ejuoy/Jump_starter/Doc/MCU-BT(1).pdf

# R8 22R ⁰⁶⁰³ C¹ ¹⁰uF/16V

## BT part

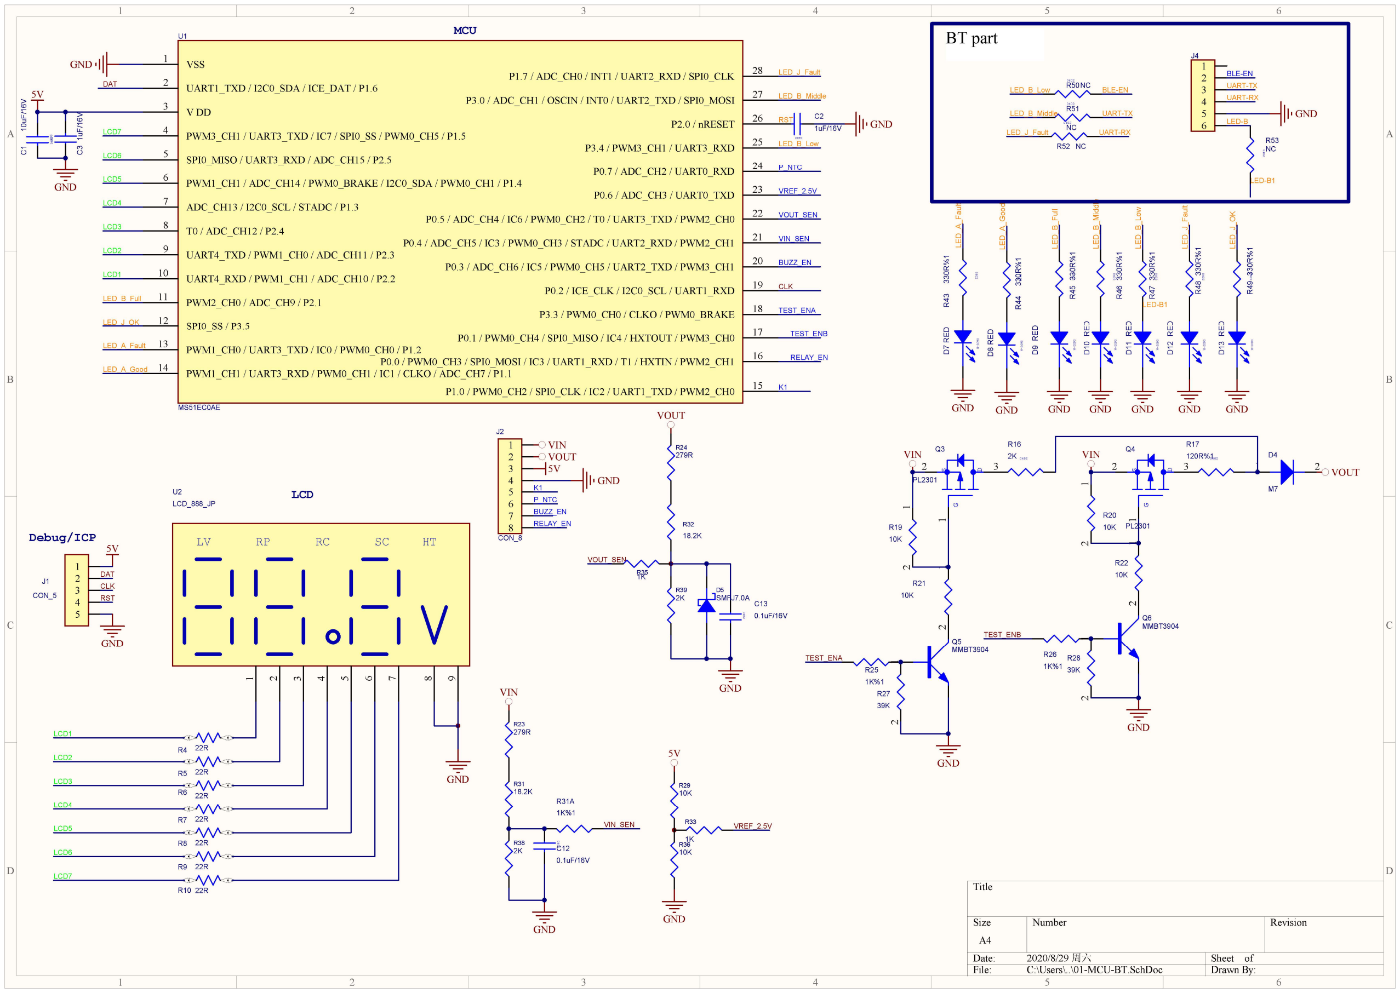
[picture p4: page 1]

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
Title

Size | Number | Revision
A4
Date: | 2020/8/29 周六 | Sheet of
File: | C:\Users\..\01-MCU-BT.SchDoc | Drawn By:

DAT
CLK
RST

LCD1

LCD2

LCD3

LCD4

LCD5

LCD6

LCD7

P_NTC

VREF_2.5V

VOUT_SEN

VIN_SEN

BUZZ_EN

TEST_ENA

TEST_ENB

CLK

DAT

RELAY_EN

LED_A_Fault

LED_A_Good

LCD1

LCD2

LCD3

LCD4

LCD5

LCD6

LCD7

LED_B_Full

LED_B_Middle

LED_B_Low

LED_J_Fault

LED_J_OK

LV | RP | RC | SC | HT 1

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
LCD_888_JP

R4 22R

VSS 1

UART1_TXD / I2C0_SDA / ICE_DAT / P1.6 2

V DD 3

PWM3_CH1 / UART3_TXD / IC7 / SPI0_SS / PWM0_CH5 / P1.5 4

SPI0_MISO / UART3_RXD / ADC_CH15 / P2.5 5

PWM1_CH1 / ADC_CH14 / PWM0_BRAKE / I2C0_SDA / PWM0_CH1 / P1.4 6

ADC_CH13 / I2C0_SCL / STADC / P1.3 7

T0 / ADC_CH12 / P2.4 8

UART4_TXD / PWM1_CH0 / ADC_CH11 / P2.3 9

UART4_RXD / PWM1_CH1 / ADC_CH10 / P2.2 10

PWM2_CH0 / ADC_CH9 / P2.1 11

SPI0_SS / P3.5 12

PWM1_CH0 / UART3_TXD / IC0 / PWM0_CH0 / P1.2 13

PWM1_CH1 / UART3_RXD / PWM0_CH1 / IC1 / CLKO / ADC_CH7 / P1.1 14
P1.0 / PWM0_CH2 / SPI0_CLK / IC2 / UART1_TXD / PWM2_CH0 | 15
P0.0 / PWM0_CH3 / SPI0_MOSI / IC3 / UART1_RXD / T1 / HXTIN / PWM2_CH1 | 16
P0.1 / PWM0_CH4 / SPI0_MISO / IC4 / HXTOUT / PWM3_CH0 | 17
P3.3 / PWM0_CH0 / CLKO / PWM0_BRAKE | 18
P0.2 / ICE_CLK / I2C0_SCL / UART1_RXD | 19
P0.3 / ADC_CH6 / IC5 / PWM0_CH5 / UART2_TXD / PWM3_CH1 | 20
P0.4 / ADC_CH5 / IC3 / PWM0_CH3 / STADC / UART2_RXD / PWM2_CH1 | 21
P0.5 / ADC_CH4 / IC6 / PWM0_CH2 / T0 / UART3_TXD / PWM2_CH0 | 22
P0.6 / ADC_CH3 / UART0_TXD | 23
P0.7 / ADC_CH2 / UART0_RXD | 24
P3.4 / PWM3_CH1 / UART3_RXD | 25
P2.0 / nRESET | 26
P3.0 / ADC_CH1 / OSCIN / INT0 / UART2_TXD / SPI0_MOSI | 27
P1.7 / ADC_CH0 / INT1 / UART2_RXD / SPI0_CLK | 28

U1

MS51EC0AE

R5 22R

R6 22R ⁰⁴⁰² | C³ ¹uF/16V | 0402

C2
1uF/16V

R7 22R

R9 22R

1
2
3
4
5

J1
CON_5

R10 22R

5V

5V

### LCD

### MCU

### Debug/ICP

VREF_2.5V

R29
10K

R33

1K
R36
10K

5V

VOUT_SEN

R39
2K

R24
279R

R32
18.2K

R35 1K

D5
SMFJ7.0A0402
C13
0.1uF/16V

VOUT

VIN_SEN

R38
2K

R31
18.2K 0402 C12

0.1uF/16V

R23
279R

VIN

R31A
1K%1

TEST_ENB

TEST_ENA | R26
1K%1 | 1 2
| R22
10K ¹ 2

R21
10K

R25
1K%1

Q6

MMBT3904 D

G

S 1

2 3

Q3

PL2301 | D

G

S 1

2 3

Q4

PL2301

0402

R17
120R%1 1 2

R28
39K

1 2

R19

10K | 1 2

R20
10K

0402

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
MMBT3904

VIN
VOUT
VIN | LED_A_Fault | LED_A_Good | LED_B_Full | LED_B_Middle | LED_B_Low | LED_J_Fault | LED_J_OK 0603-R D¹² RED ⁰⁴⁰² R⁴⁵ ³³⁰R%¹ | 0402 R⁴⁶ ³³⁰R%¹ | 0603-R D¹³ RED 0603-R D⁷ RED | 0402 R⁴⁹ ³³⁰R%¹ 0603-R D¹⁰ RED ⁰⁴⁰² R⁴⁴ ³³⁰R%¹ | 0402 R⁴⁷ ³³⁰R%¹ 0603-R D¹¹ RED | 0402 R⁴⁸ ³³⁰R%¹ 0603-R D⁹ RED ⁰⁴⁰² R⁴³ ³³⁰R%¹ | 0603-R D⁸ RED

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
CON_8

VIN
VOUT
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
GND | GND | GND | GND | GND | GND | GND

RELAY_EN

P_NTC
BUZZ_EN

0402
R50NC LED_B_Low | BLE-EN

0402
R51

NC

LED_B_Middle | UART-TX

0402

R52 NC

UART-RX

K1

LED-B1 ⁰⁴⁰²

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
BLE-EN
UART-TX
UART-RX

LED-B

GND

K1

RST

LED-B1

LED_J_Fault
