ejuoy/Jump_starter/Doc/继电器-sch(1).pdf

1

2

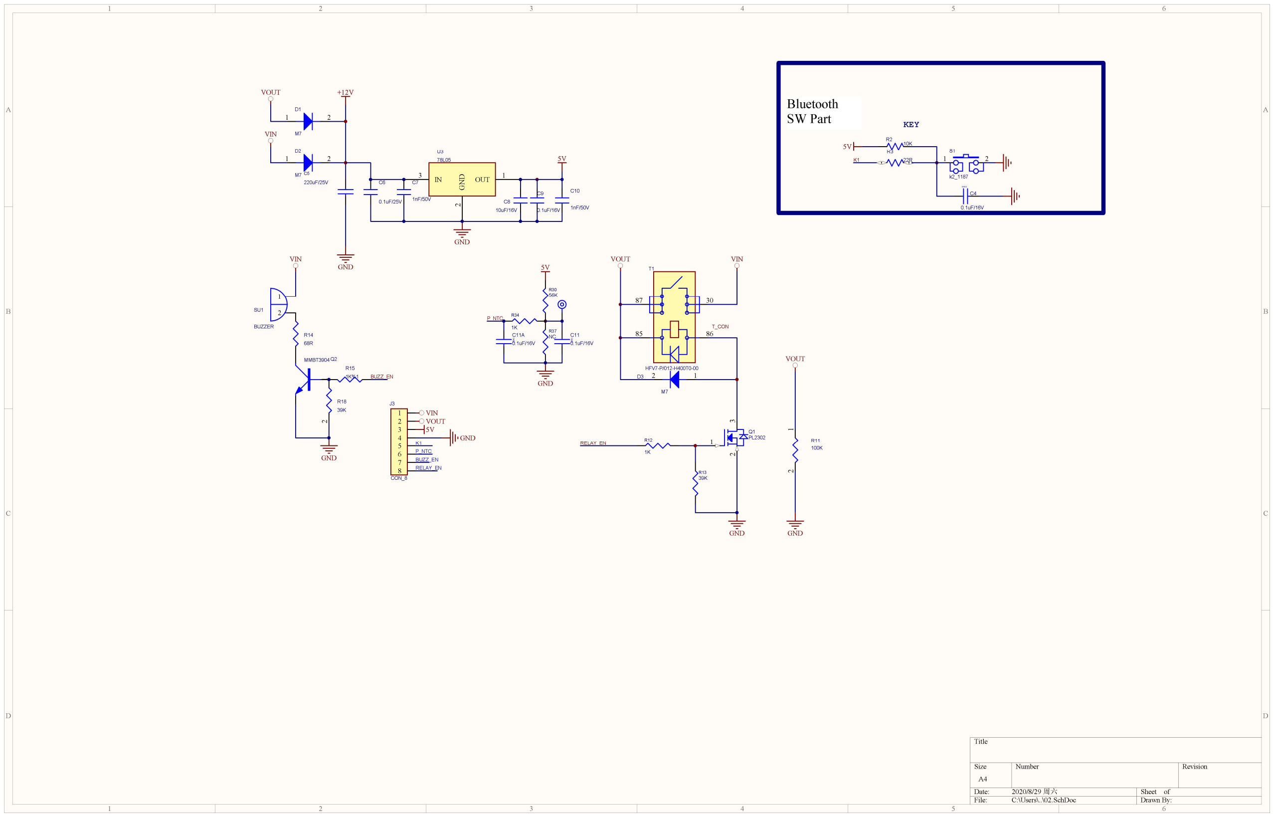
[picture p5: page 1]

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
## Title

Size | Number | Revision
A4
Date: | 2020/8/29 周六 | Sheet of
File: | C:\Users\..\02.SchDoc | Drawn By:

RELAY_EN

P_NTC
T_CON

C9

0.1uF/16V

R13
39K

C7

1nF/50V

85 86

87 30

T1

HFV7-P/012-H400T0-00

## OUT 1 GND

2

IN 3

U3
78L05

C10

1nF/50V

D3 | 2 | 1

M7

C5
220uF/25V

1 2

D2

M7
C6

0.1uF/25V

3

1 2

Q1
PL2302

1 2

D1

M7

R30
56K

C8
10uF/16V

R12

1K | 1 2
R11
100K

R34

1K
R37
NC C11 0402 0.1uF/16V

+12V

5V

## VIN

## VOUT

## VOUT

VOUT | VIN

BUZZ_EN

MMBT3904Q2

1

2

SU1

BUZZER
R14
68R

R15
1K%1 1 2

R18
39K

## VIN

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
CON_8

## VIN VOUT

5V

## GND

RELAY_EN

P_NTC
BUZZ_EN

## GND

## GND

## GND

## GND

## GND

## GND

K1

K1

R2
10K

0402
C4

0.1uF/16V

1 2

S1

k2_1187

R3
22R

5V

## KEY

# Bluetooth SW Part

C11A 0402 0.1uF/16V
