ejuoy/Jump_starter/Doc/JSBT100.pdf

# POWER- POWER-

# 14.8V POWER-

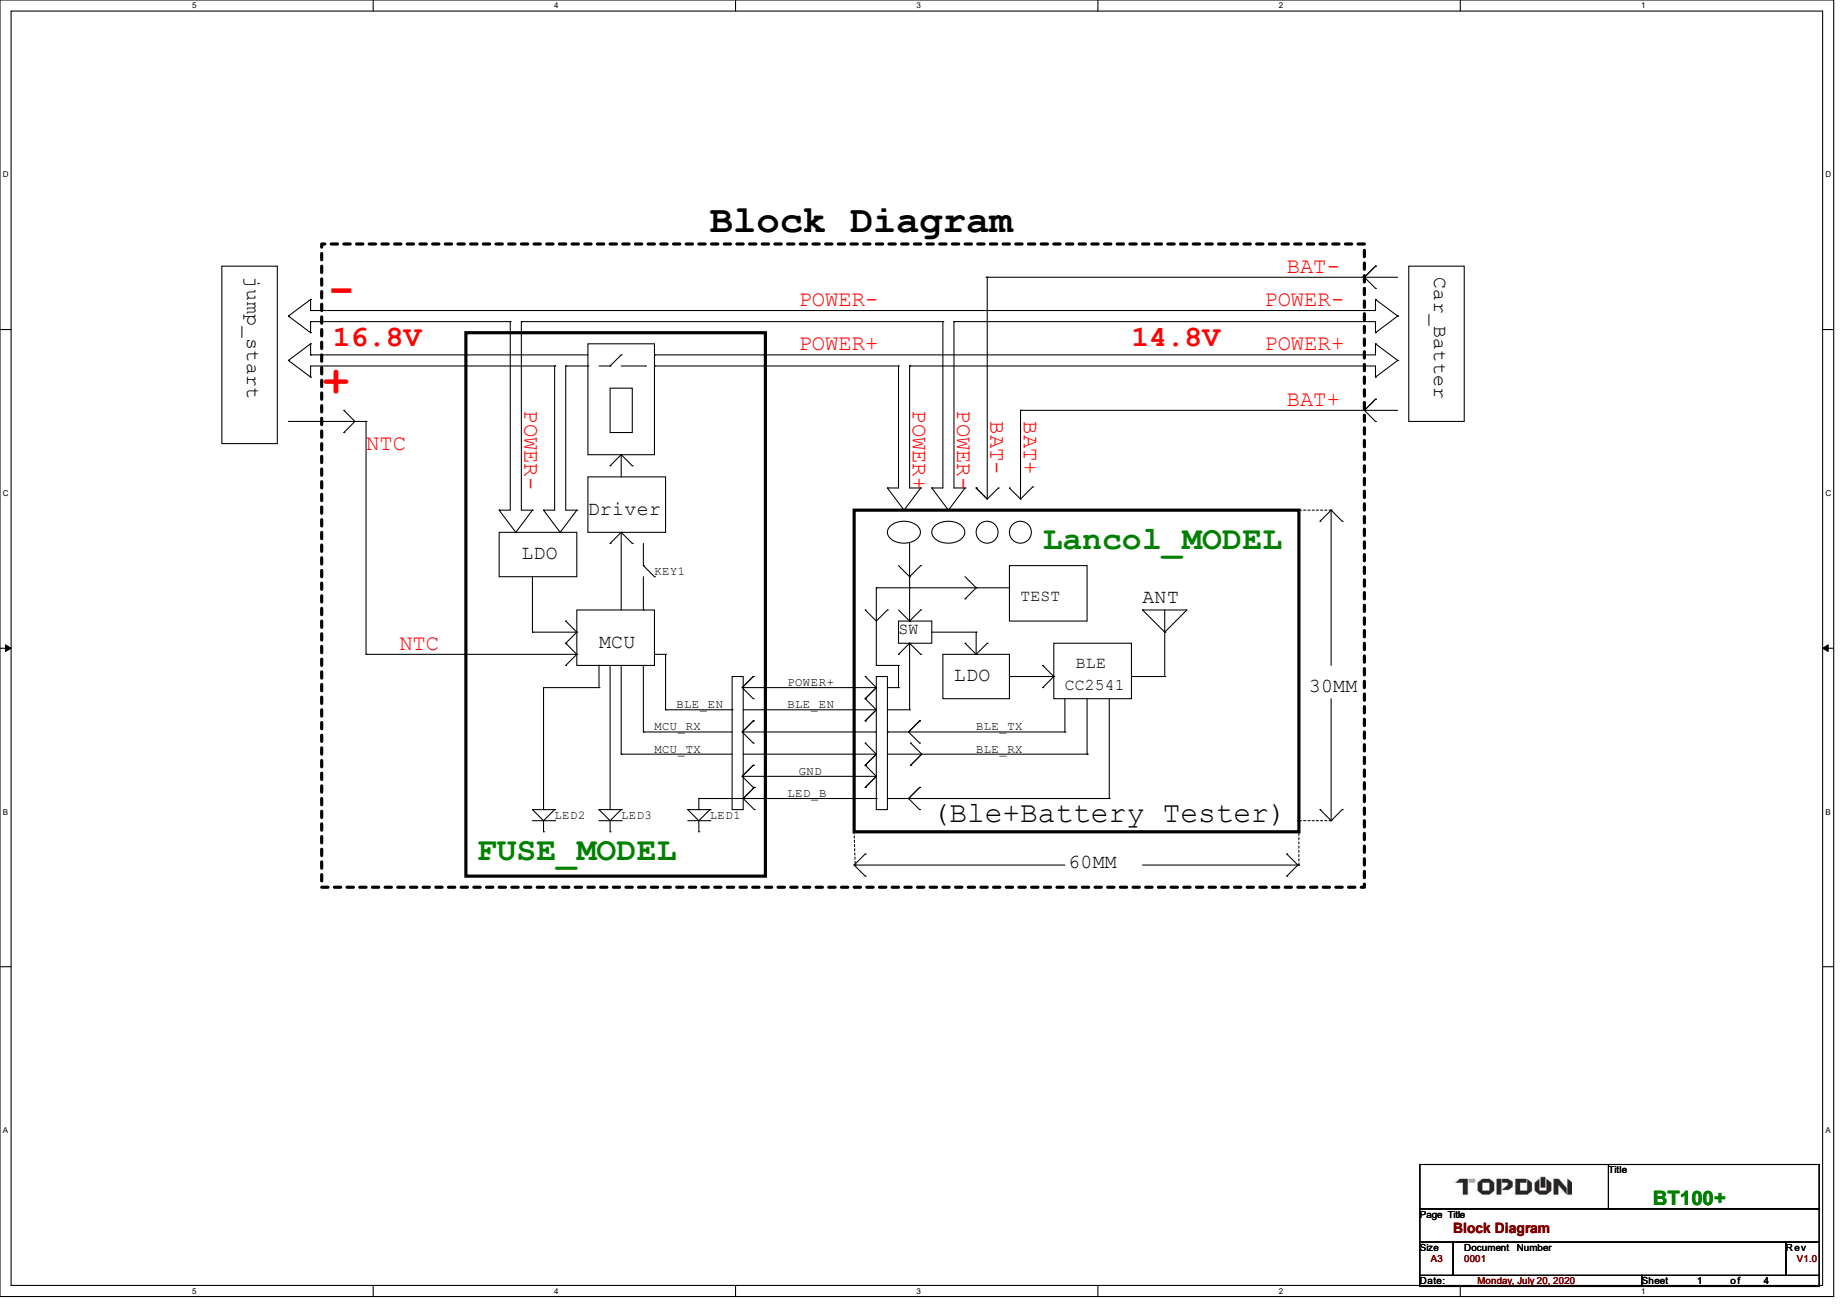
[picture p8: page 1]
Lancol_MODEL; MCU jump_start; BAT-; Car_Batter; BAT+; POWER+; (Ble+Battery Tester); 30MM BAT- BAT+; FUSE_MODEL; POWER-; LDO; Driver; LED2; LED3; LED1; KEY1; NTC; BLE; TEST; CC2541 LDO; ANT; Block Diagram; MCU_RX; MCU_TX; LED_B; GND; BLE_EN; BLE_TX; BLE_RX; Title; Size; Document Number; Date:; Sheet; Page Title0001; Monday, July 20, 2020; 4 Block Diagram

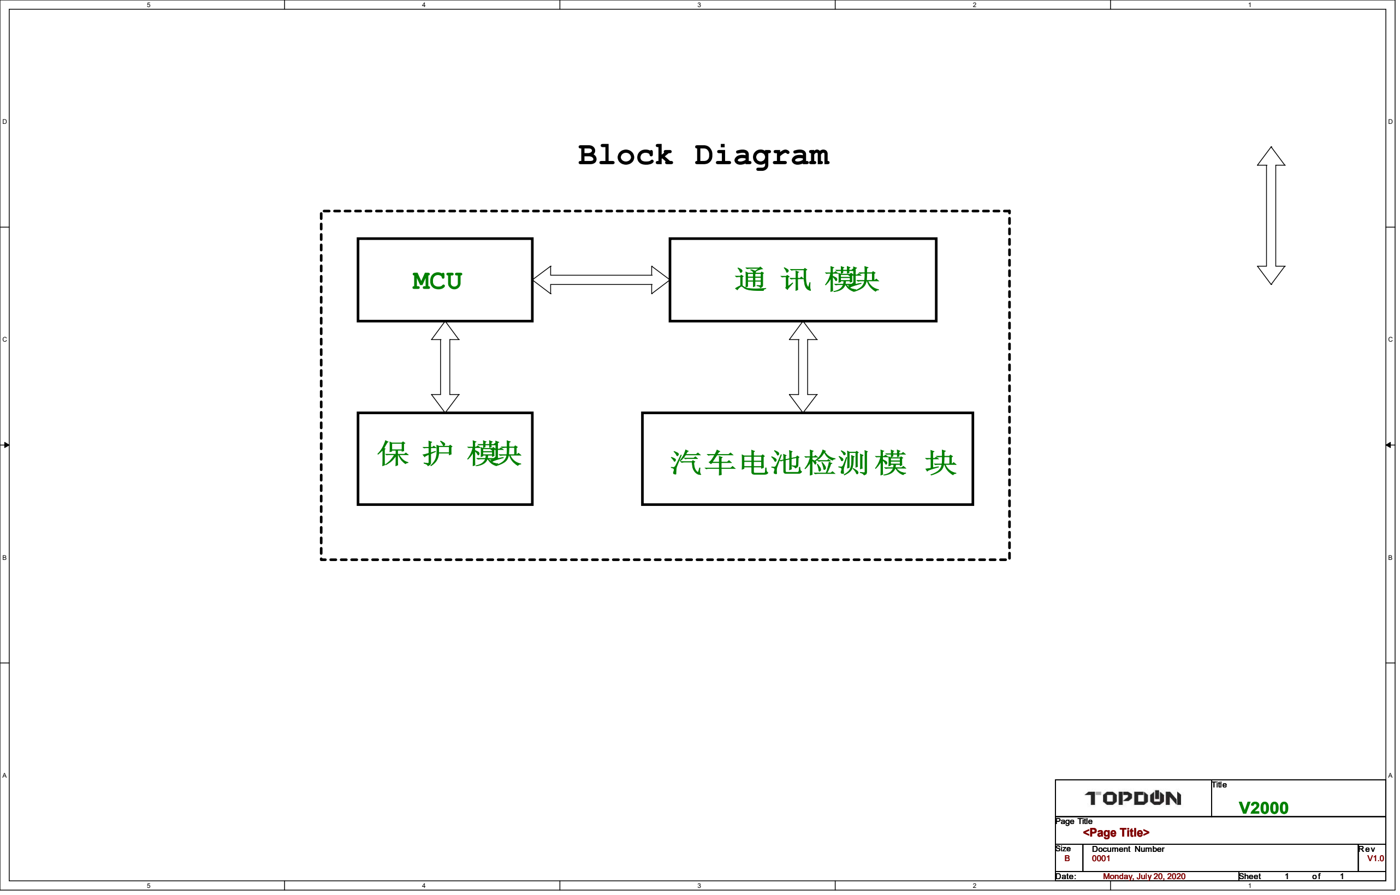
[picture p9: figure]
Block Diagram; 汽车电池检测模 块; MCU; Title; Size; Document Number; Rev; Date:; Sheet; Page Title0001; Monday, July 20, 2020; 1 <Page Title>

MCU | Debug

### BUZZ_EN

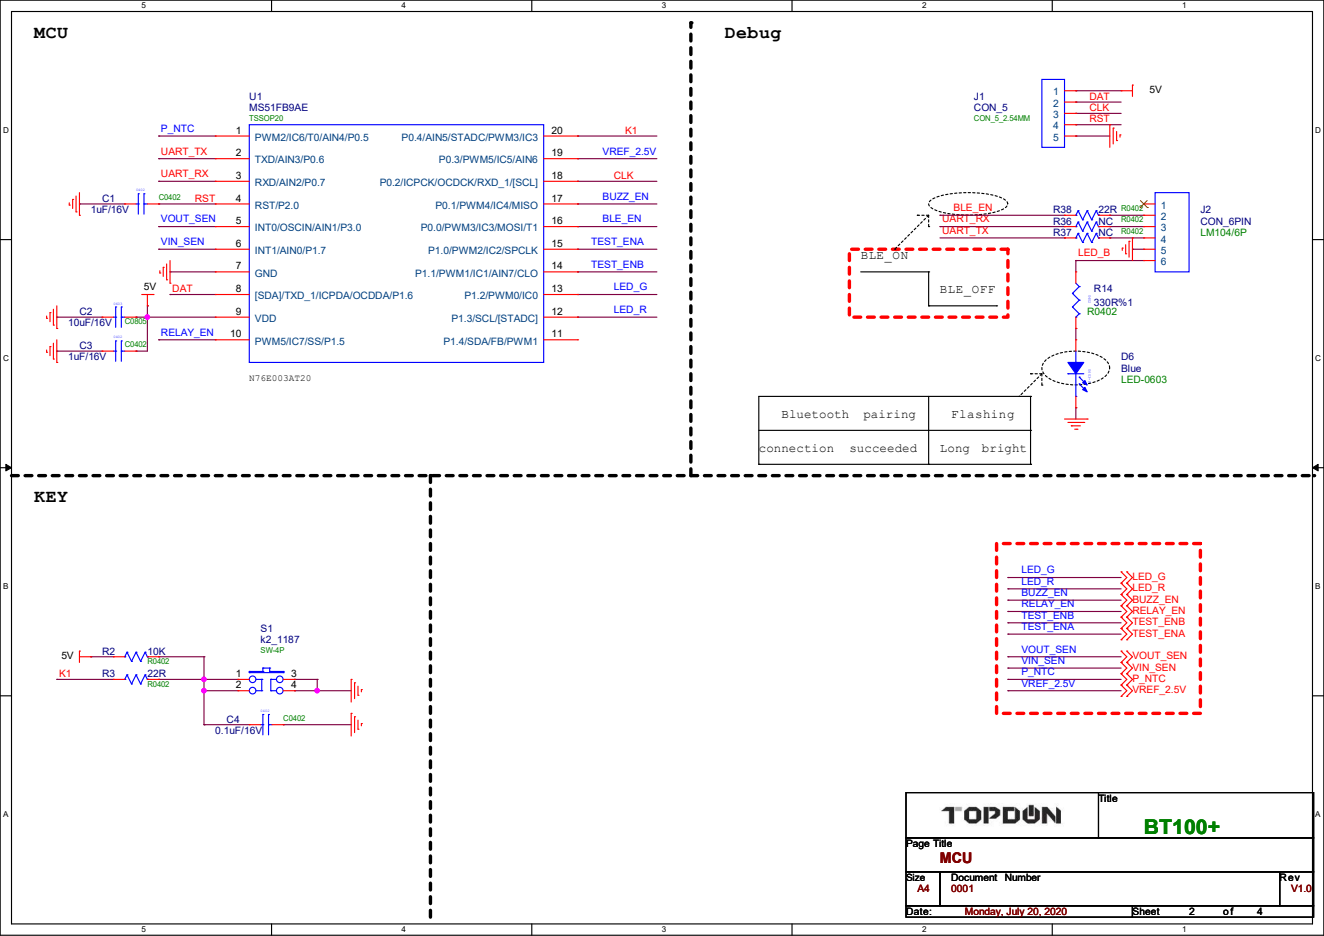
[picture p10: page 3]

Bluetooth pairing | Flashing

connection succeeded | Long bright

# 2 C7

# TP5 TEST_PIN1.2MMB 0402 R12

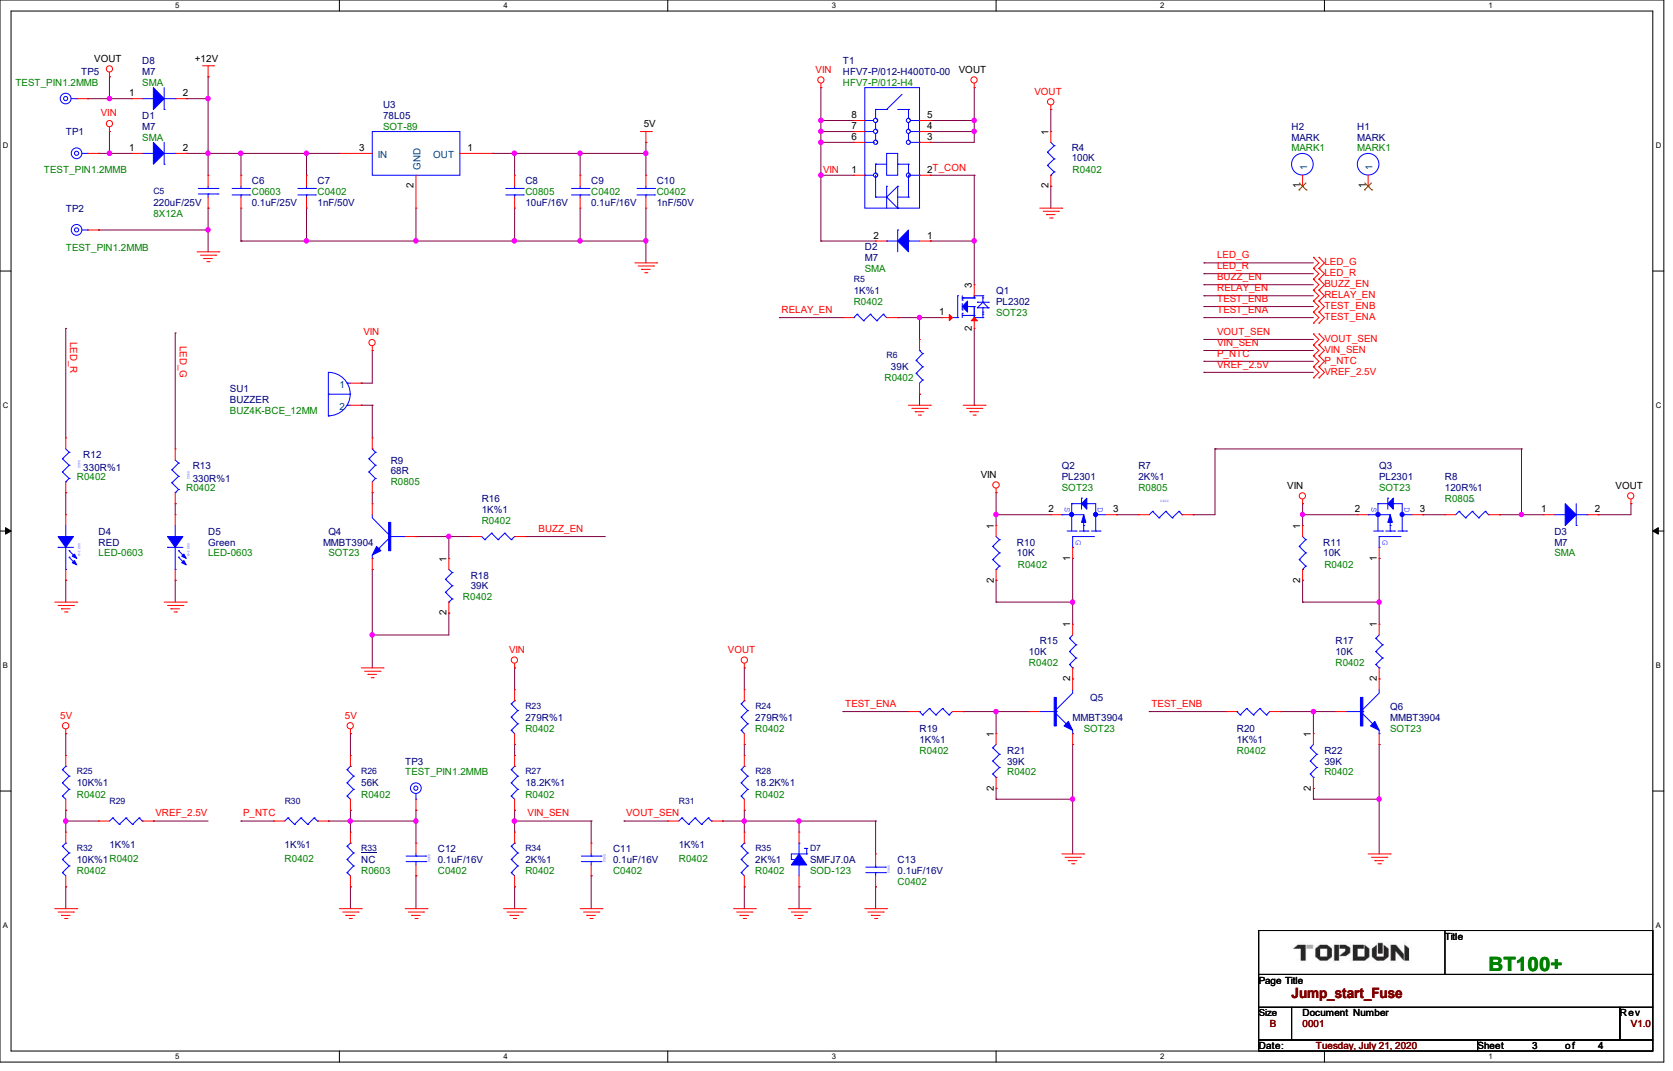
[picture p11: page 4]
