ejuoy/Jump_starter/Doc/jsbt100_v1_2020703.pdf

# Lancol_MODEL

## MCU

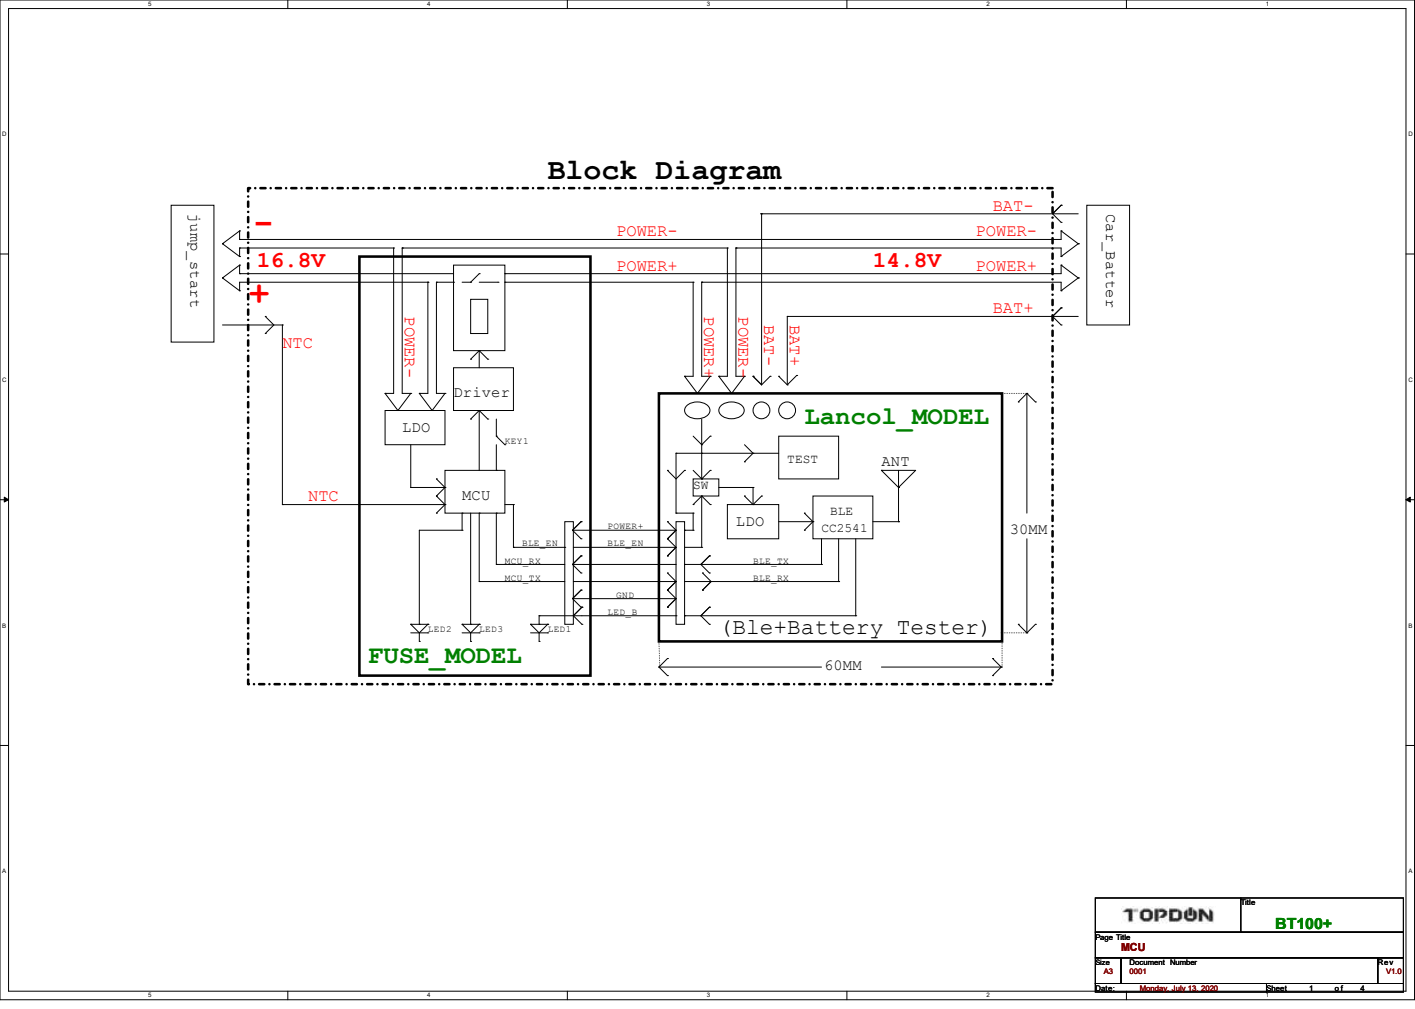
[picture p12: page 1]
jump_start; BAT-; Car_Batter; BAT+; POWER+; POWER-; FUSE_MODEL; LDO; Driver; LED2; LED3; LED1; KEY1; NTC; BLE; TEST; CC2541 LDO; ANT; Block Diagram; MCU_RX; MCU_TX; LED_B; GND; BLE_EN; BLE_TX; BLE_RX; Title; Size; Document Number; Rev; Date:; Sheet; Page Title; Monday, July 13, 2020; MCU

(Ble+Battery Tester)

MCU | Debug

### BLE_OFF

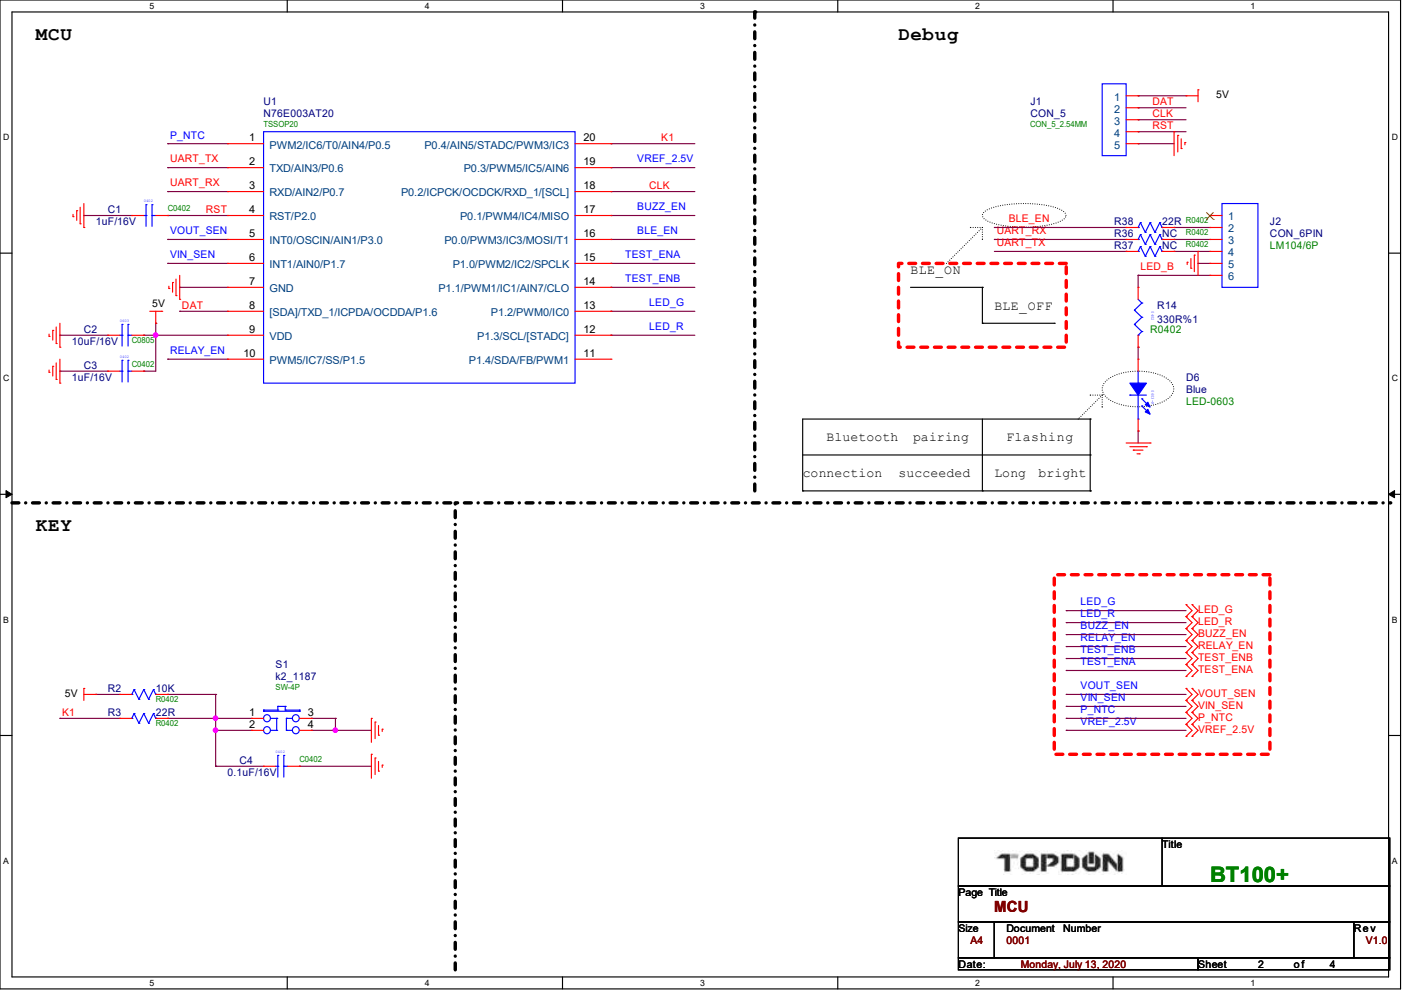
[picture p13: page 2]

Bluetooth pairing | Flashing

connection succeeded | Long bright

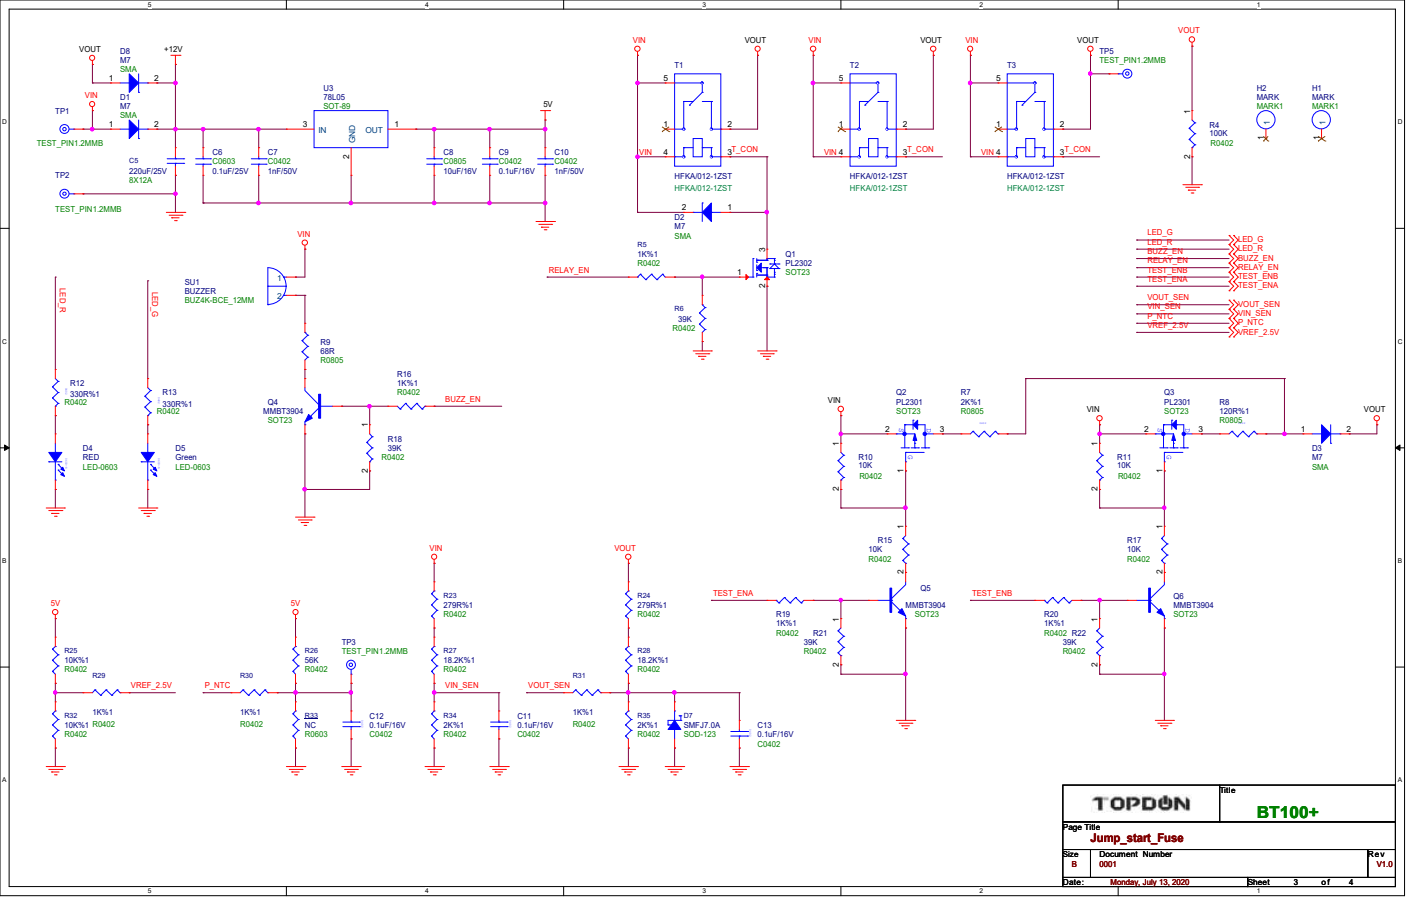
[picture p14: page 3]
