ejuoy/Jump_starter/Softcode/Src/App/jump_star.h

#ifndef _JUMP_START_H_
#define _JUMP_START_H_



sbit P_NTC    = P0^7;
sbit BUZZ_EN  = P0^3;
sbit TEST_ENA = P3^3;
sbit TEST_ENB = P0^1;
sbit RELAY_EN = P0^0;
sbit GPIO_KEY = P0^6;

enum _JUMP_WORK_STATUS_
{
    WORK_NULL = 0 ,
    WORK_BATTERY ,
    WORK_JUMP ,
    WORK_KEY  ,
    WORK_BOTH 
};

enum _JUMP_KEY_STATUS_
{
    KEY_NULL = 0 ,
    KEY_RUNNING ,
    KEY_TEST
};


#define WOKR_KEY_PRESS_TIME 1000
#define JUMP_VOUT_AVG_MAX	160
#define JUMP_VOUT_AVG_MIN	70
#define JUMP_VOUT_MUL_VALUE	3

#define JUMP_JUDGE_VOUT_NUM 10

#define JUMP_VIN_LOW   140

#define JUMP_VOUT_SHORT_ERROR   10
#define JUMP_VOUT_OVER_ERROR    157		

#define JUMP_VIN_LAST_LOW		 100
#define JUMP_VIN_NOT_ACCESS		 10

#define JUMP_VOUT_BATTER_ERROR   40
#define JUMP_VOUT_BATTER_LOW     115
#define JUMP_VOUT_BATTER_MIDDLE  120
#define JUMP_VOUT_BATTER_FULL    130
#define JUMP_VOUT_BATTER_GOOD    139
#define JUMP_VOUT_BATTER_FAULT   150
#define JUMP_VOUT_BATTER_MCU	 80
#define JUMP_RELAY_CNT_TIME		 10



void jumpstar_key_timecnt(void);
void jumpstart_gpio_init(void);
void jumpstart_vout_produce(void);
void jumpstart_been_wave(void);

void jumpstart_relay_control(void);
void jumpstart_handle_process(void);

#endif
