ejuoy/Jump_starter/(commit log)

2020-09-03 add printf and codeing
2020-09-08 alter input lcd pin
2020-09-10 add adc and vcc show
2020-09-12 alter buzz and RELAY_EN
    [app_adc.c, app_timer.c, digital_lcd.c, jump_star.c, jump_star.h, main.c]
2020-09-12 coding led and mode
2020-09-12 alter led display ok
2020-09-12 alter jump led star
2020-09-13 alter vout battery function
2020-09-19 power delay time
2020-09-19 alter pwm been
